andreika-git/prometheus/hardware/prometheus-bare-pcb.jpg

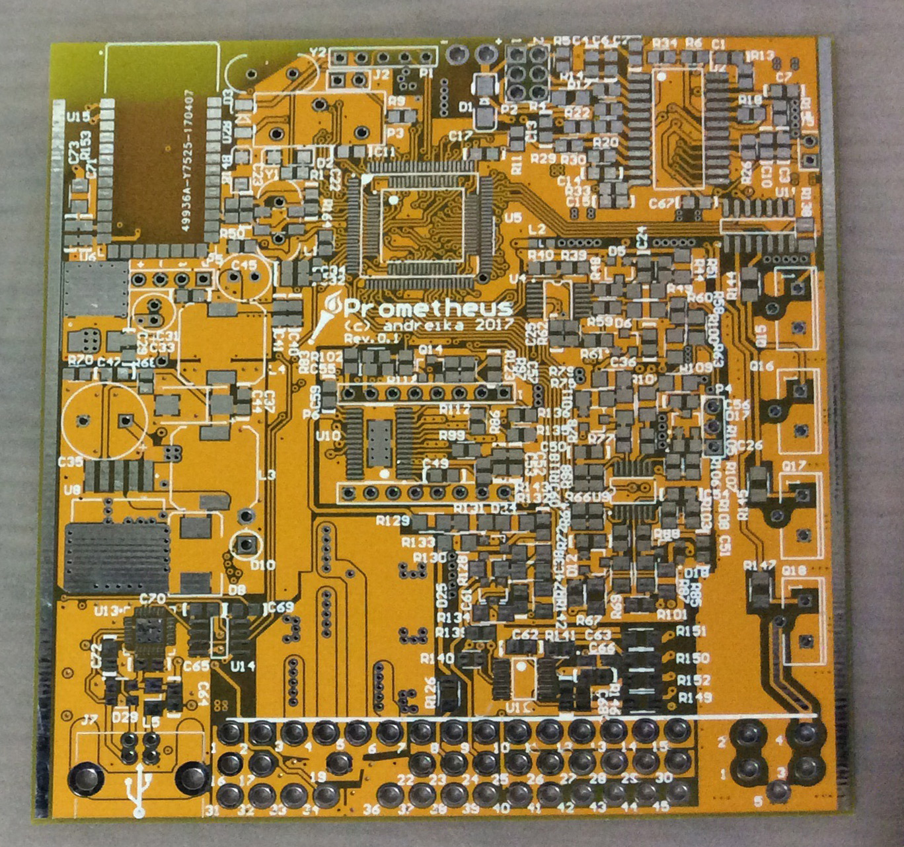
hardware/prometheus-bare-pcb.jpg
