andreika-git/prometheus/hardware/prometheus-pcb-3d-top.jpg

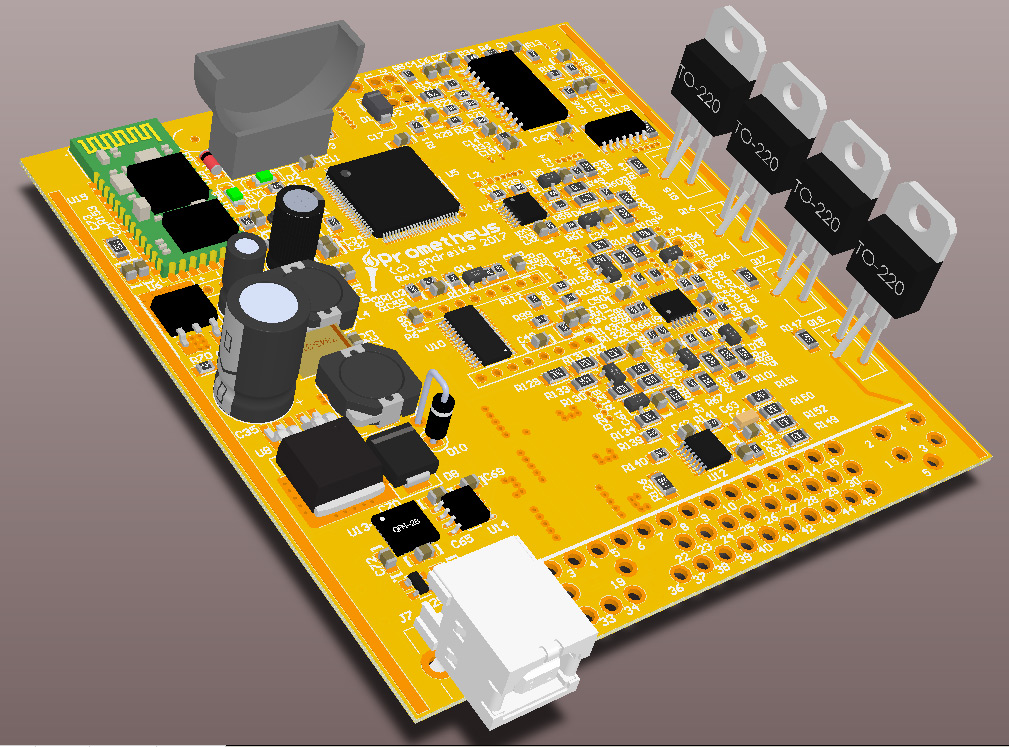
hardware/prometheus-pcb-3d-top.jpg
