andreika-git/prometheus/README.md

*** Hardware Project "Prometheus" ***

See http://rusefi.com/forum/viewtopic.php?f=4&t=1215

Revision 0.020 2018-01-30
Copyright (c) 2017-2018 andreika (prometheus.pcb@gmail.com)

Licensed under the TAPR Open Hardware License (www.tapr.org/OHL)
See LICENSE.TXT for details.

Disclaimer and licence

THIS DOCUMENTATION (SCHEMATIC DIAGRAMS, LAYOUT FILES etc.) IS PROVIDED "AS IS", 
WITHOUT WARRANTY OF ANY KIND, EXPRESS OR IMPLIED, INCLUDING BUT NOT LIMITED TO 
THE WARRANTIES OF MERCHANTABILITY, FITNESS FOR A PARTICULAR PURPOSE AND NONINFRINGEMENT.

IN NO EVENT SHALL THE AUTHORS OR COPYRIGHT HOLDERS BE LIABLE FOR ANY CLAIM, 
DAMAGES OR OTHER LIABILITY, WHETHER IN AN ACTION OF CONTRACT, TORT OR OTHERWISE, 
ARISING FROM, OUT OF OR IN CONNECTION WITH THE DOCUMENTATION OR THE USE OR OTHER 
DEALINGS IN THE DERIVED PRODUCTS.

Author of the Prometheus project is not liable for any damage caused to you or your car
by using this documentation or any associated products.
Whatever you do, you do at your own risk and on your own responsibility!
Please be aware that it may affect your safety and the safety of others.
