andreika-git/prometheus/html/src/readme.txt

Generator scripts for Prometheus Interactive Map.

Created for rusEFI/Prometheus project.

(c) andreika, 2017 (prometheus.pcb@gmail.com)

http://rusefi.com/forum/viewtopic.php?f=4&t=1215
http://github.com/andreika-git/prometheus/
