andreika-git/prometheus/hardware/prometheus-pcb-3d-bottom.jpg

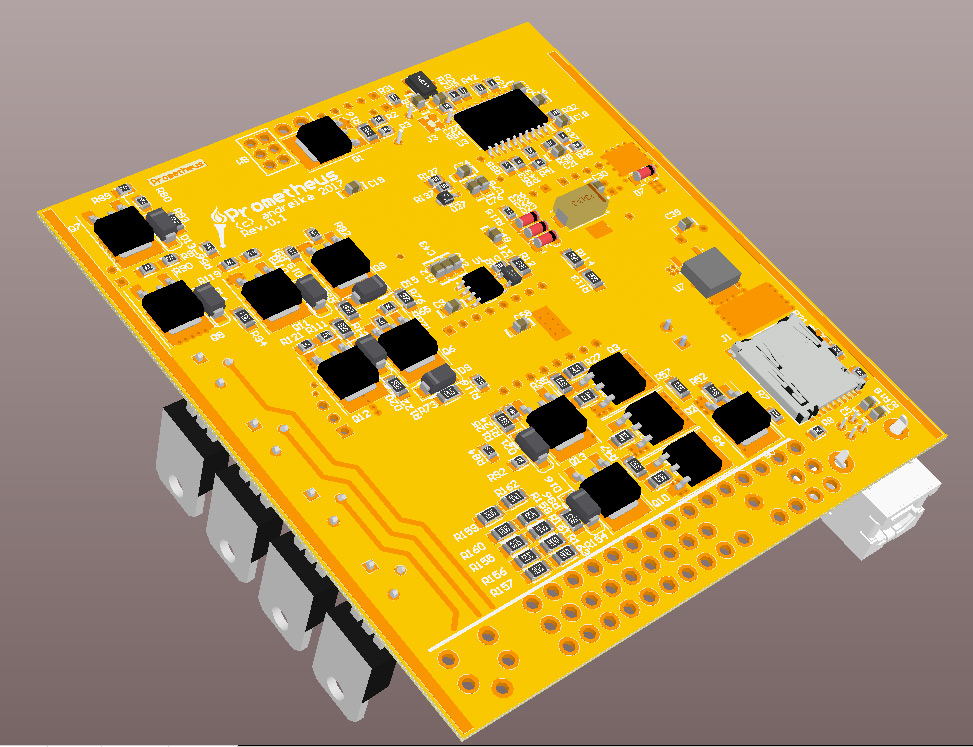
hardware/prometheus-pcb-3d-bottom.jpg
