andreika-git/prometheus/hardware/prometheus-pcb-all-layers.png

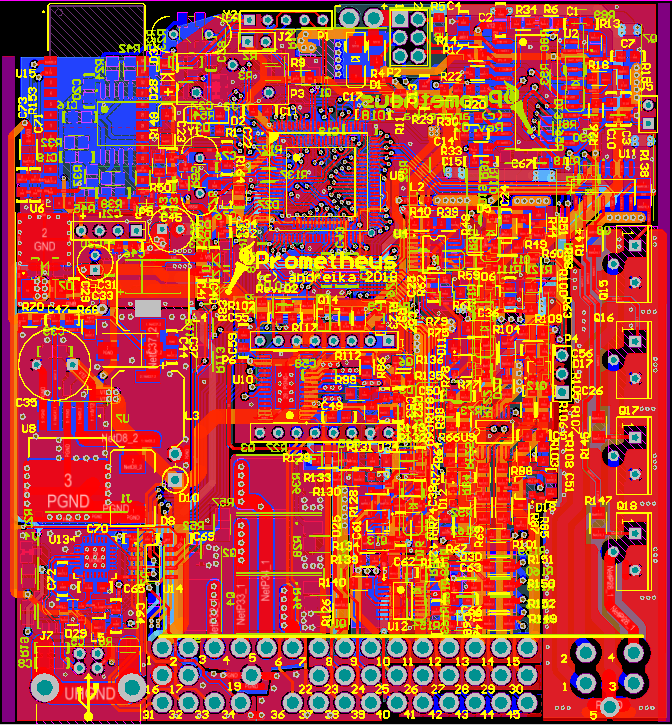
hardware/prometheus-pcb-all-layers.png
