andreika-git/prometheus/hardware/prometheus-pcb-bottom.jpg

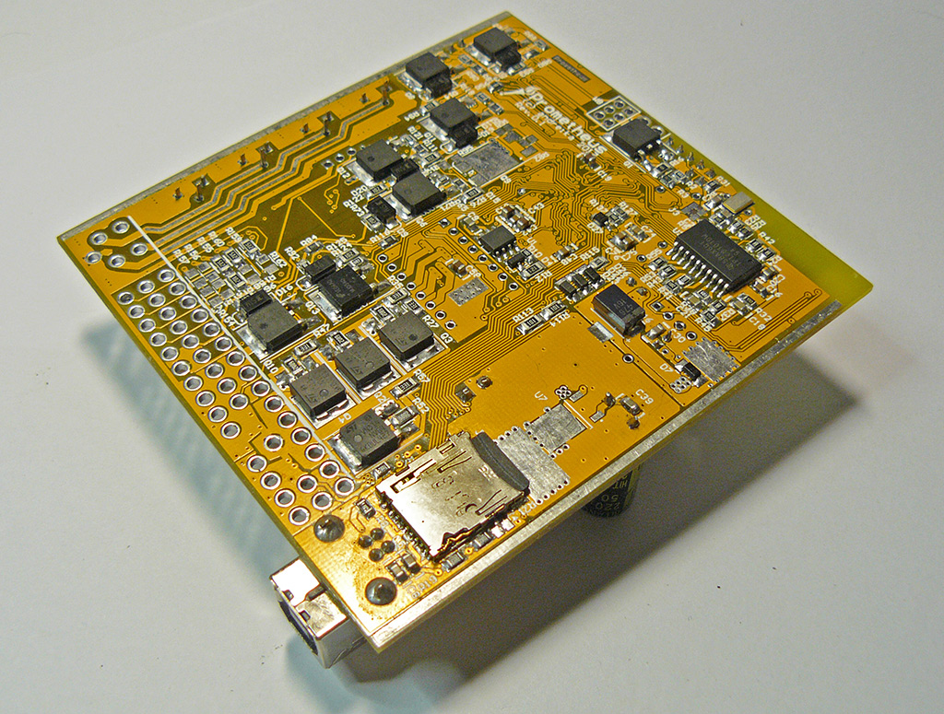
hardware/prometheus-pcb-bottom.jpg
