andreika-git/prometheus/hardware/prometheus-pcb-layers.png

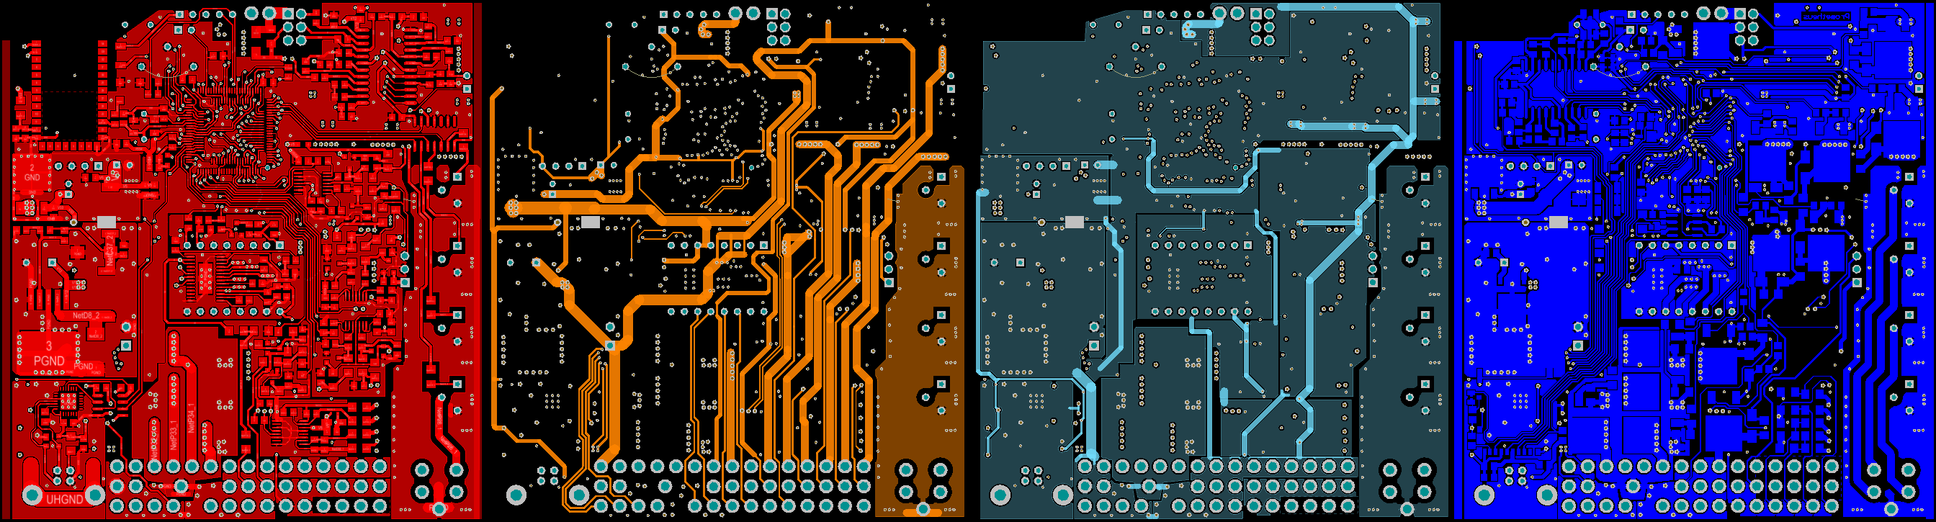
hardware/prometheus-pcb-layers.png
