andreika-git/prometheus/hardware/prometheus-port-mapping.png

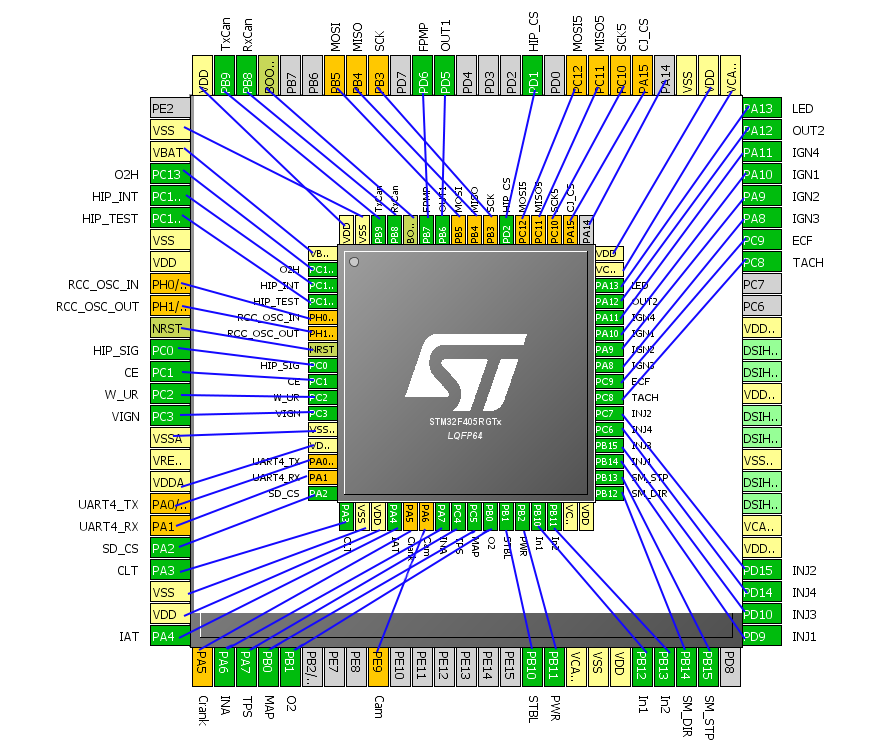
hardware/prometheus-port-mapping.png
