andreika-git/prometheus/html/img/hc-06.jpg

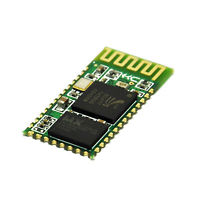
html/img/hc-06.jpg
