andreika-git/prometheus/html/img/image_na.jpg

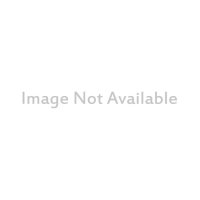
html/img/image_na.jpg
