andreika-git/prometheus/html/prometheus-pcb-rev0010-photo1.jpg

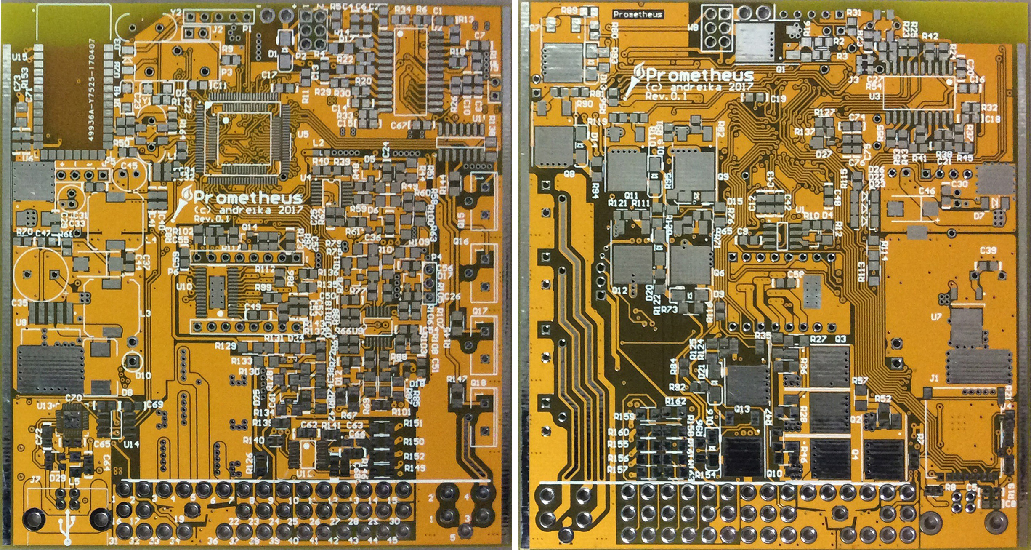
html/prometheus-pcb-rev0010-photo1.jpg
