andreika-git/prometheus/hardware/prometheus-schematic.pdf

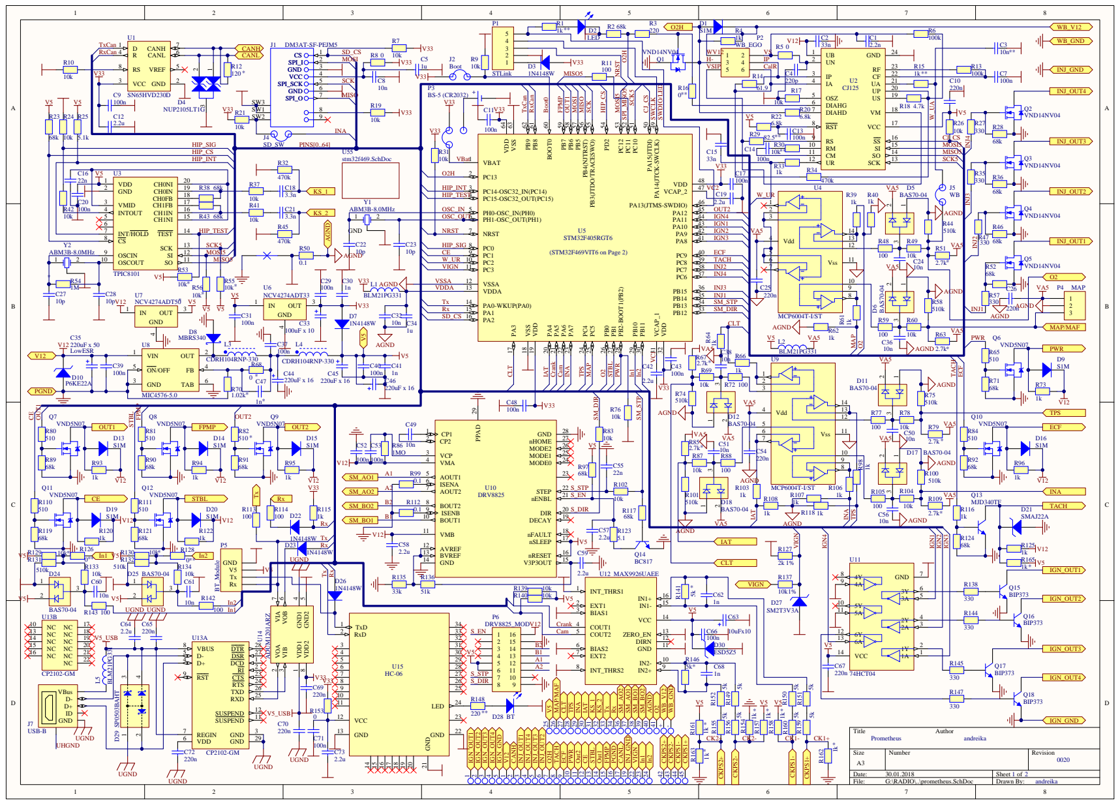
[picture p11: page 1]

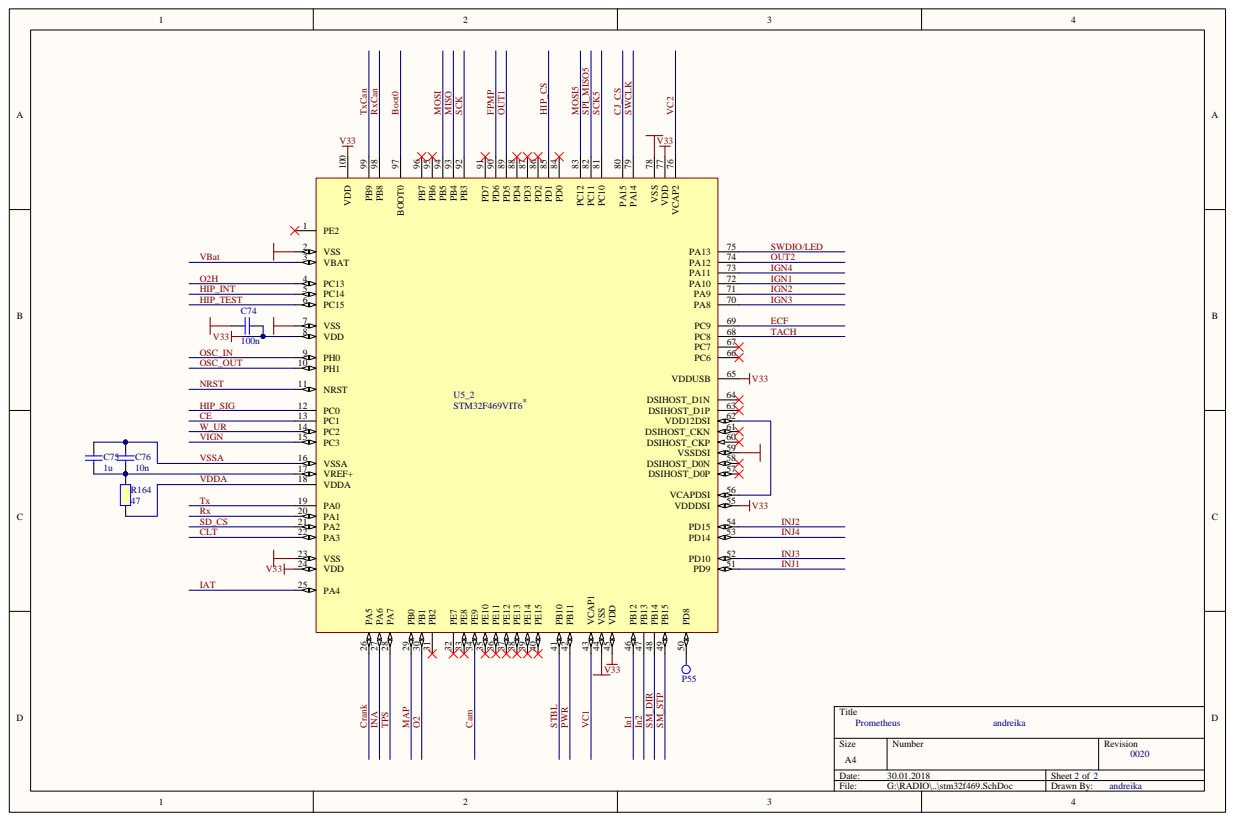
[picture p12: page 2]
Title; Size; Number; Revision; Date:; Sheet of; File:; G:\RADIO\..\stm32f469.SchDoc; Drawn By:; VSSA 16 VREF+ 17; VSS 23; VCAP1 43 VSS 44; VDD 45; VDDDSI; 55 VCAPDSI; DSIHOST_D0P; 57 DSIHOST_D0N; 58 VSSDSI; DSIHOST_CKN; 61 VDD12DSI; VSS 2 VBAT 3; VDD 8; NRST 11; VDD 24; VSS 7; DSIHOST_CKP; DSIHOST_D1N; VDDA 18; DSIHOST_D1P; VDDUSB; VCAP2 76 VDD 77 VSS 78; BOOT0 97; VDD 100; U5_2 STM32F469VIT6; VBat; V33 Boot0; VC² VC¹; VSSA; VDDA; OSC_IN OSC_OUT; NRST; HIP_SIG CE; VIGN; Tx Rx SD_CS CLT; IAT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
