andreika-git/prometheus/hardware/prometheus-wiring-diagram.pdf

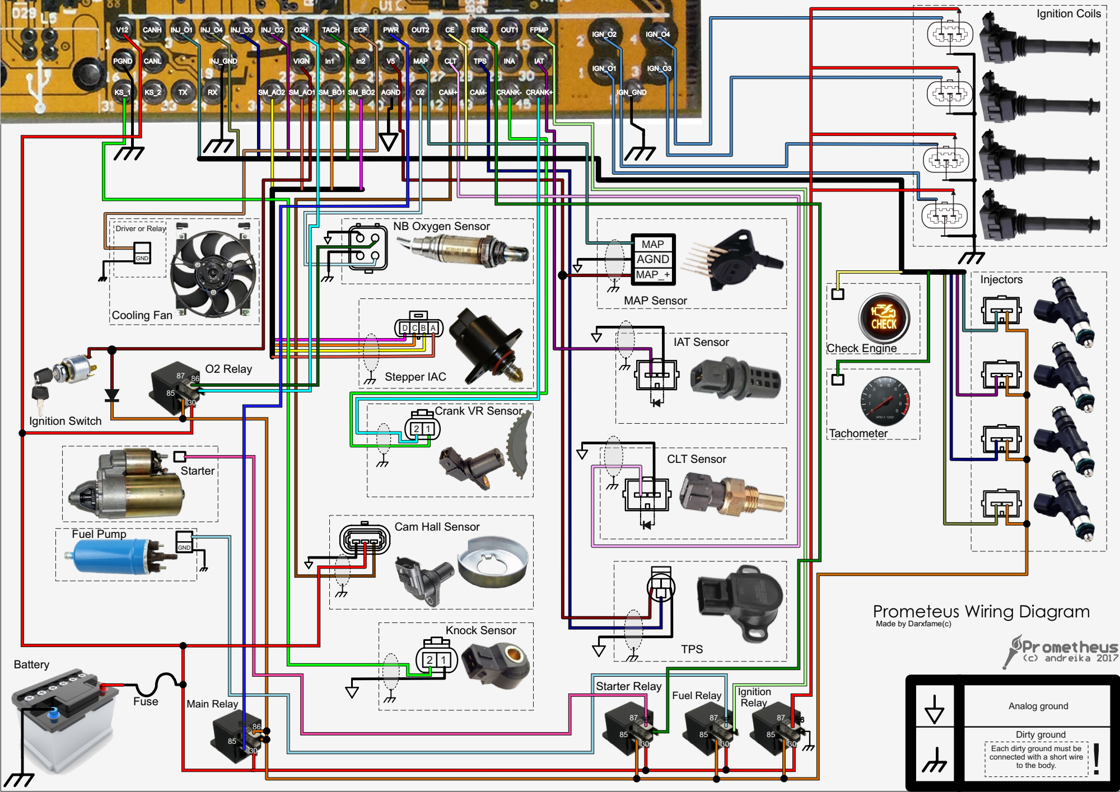
[picture p13: page 1]
Dirty ground; Analog ground; to the body.; MAP_+; AGND; MAP; GND; PGND; CANL; INJ_GND; CANH; INJ_O1; INJ_O4; INJ_O3; INJ_O2; VIGN; TACH; ECF; PWR; OUT2; STBL; CLT; CAM+; CAM-; TPS; OUT1; FPMP; INA; IAT; CRANK- CRANK+; IGN_GND; IGN_O1; IGN_O3; IGN_O2; IGN_O4; Ignition Coils; Injectors; Check Engine; Tachometer; MAP Sensor; IAT Sensor; CLT Sensor; Stepper IAC; Knock Sensor; Cooling Fan; Ignition Switch; Starter; Fuel Pump; Battery; Fuse; O2 Relay; Main Relay; Starter Relay; Fuel Relay; Ignition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

NB Oxygen Sensor

Driver or Relay

Crank VR Sensor

Cam Hall Sensor

Prometeus Wiring Diagram Made by Darxfame(c)

Each dirty ground must be
connected with a short wire
