andreika-git/prometheus/hardware/prometheus-assembly.pdf

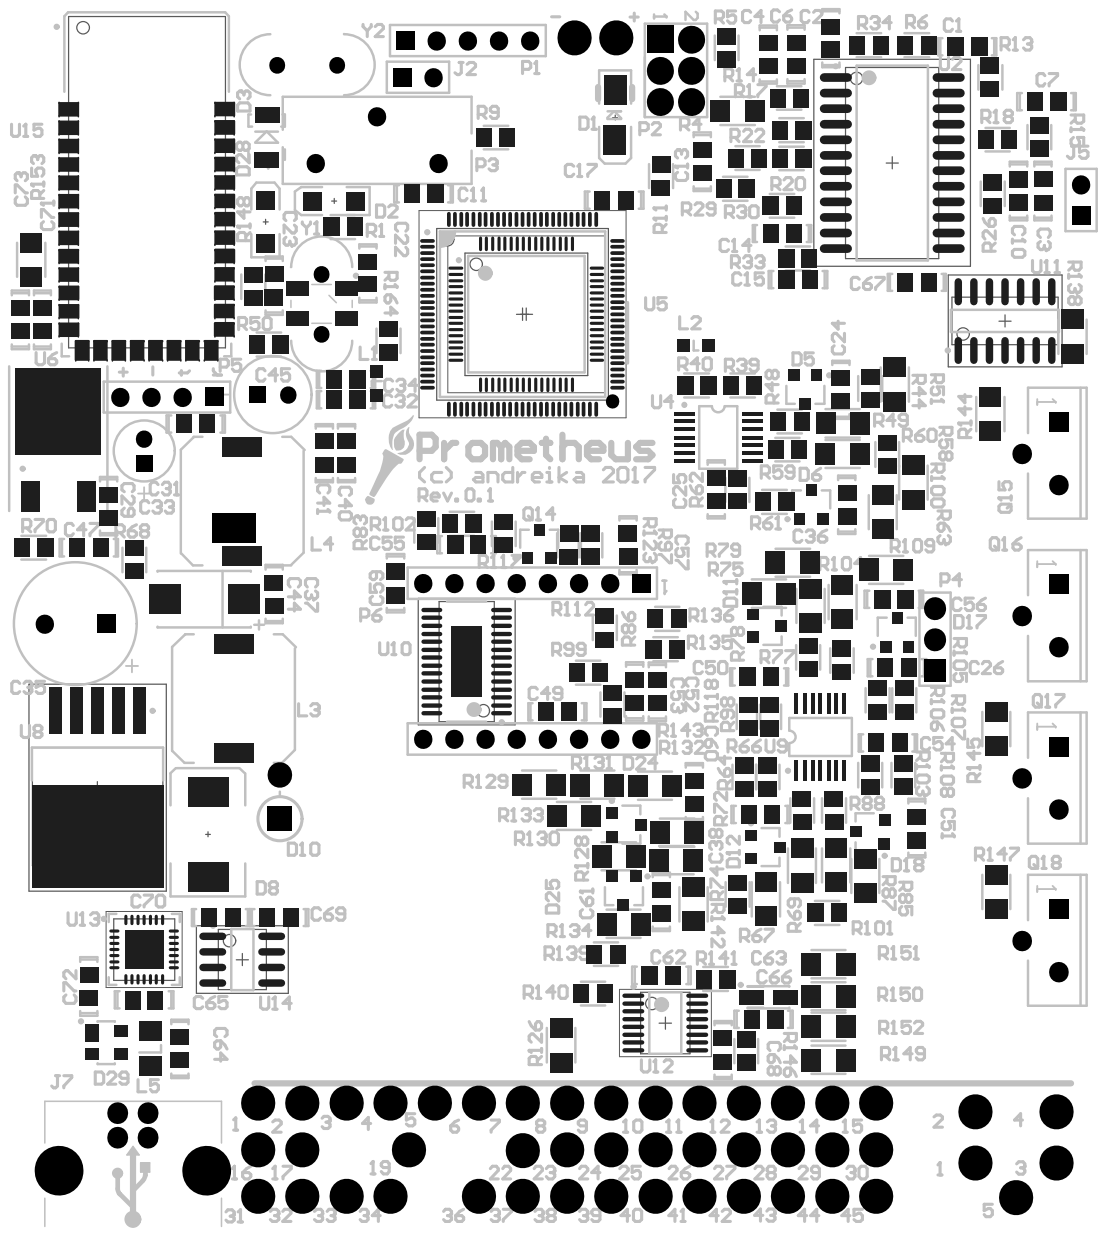
[picture p14: page 1]

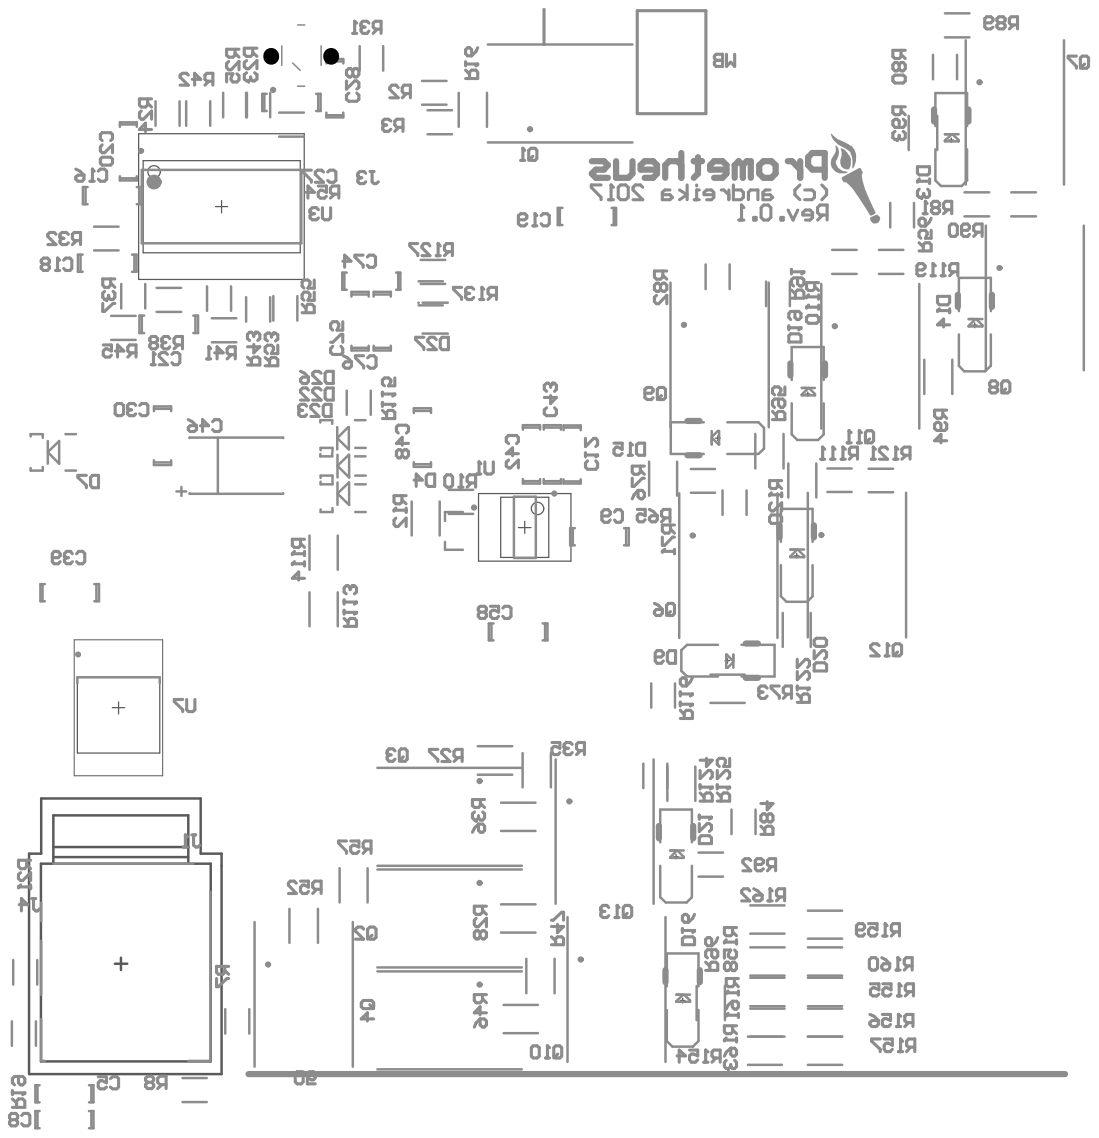
[picture p15: page 2]

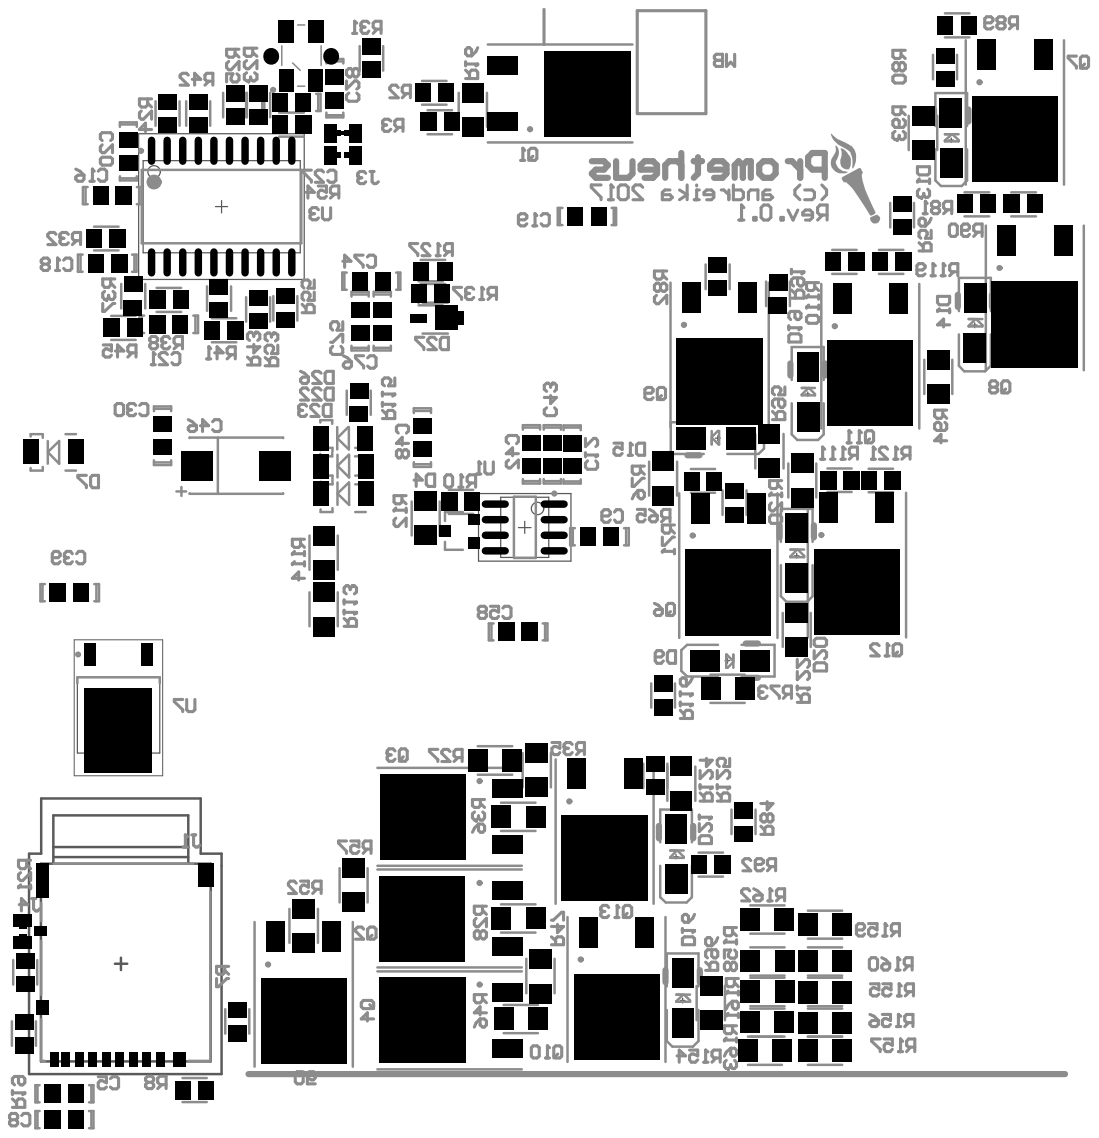
[picture p16: page 4]
