andreika-git/prometheus/hardware/pinout-stm32f469.ioc

Mcu.UserName=STM32F469VITx
PA0/WKUP.Signal=UART4_TX
PA1.Signal=UART4_RX
PA10.GPIO_Label=IGN1
PA10.Signal=GPIO_Output
PA11.GPIO_Label=IGN4
PA11.Signal=GPIO_Output
PA12.GPIO_Label=OUT2
PA12.Signal=GPIO_Output
PA13.GPIO_Label=LED
PA13.Signal=GPIO_Output
PA15.GPIO_Label=CJ_CS
PA15.Signal=SPI3_NSS
PA2.GPIO_Label=SD_CS
PA2.Signal=GPIO_Output
PA3.GPIO_Label=CLT
PA3.Signal=ADCx_IN3
PA4.GPIO_Label=IAT
PA4.Signal=ADCx_IN4
PA5.GPIO_Label=Crank
PA5.Signal=S_TIM2_CH1_ETR
PA6.GPIO_Label=INA
PA6.Signal=ADCx_IN6
PA7.GPIO_Label=TPS
PA7.Signal=ADCx_IN7
PA8.GPIO_Label=IGN3
PA8.Signal=GPIO_Output
PA9.GPIO_Label=IGN2
PA9.Signal=GPIO_Output
PB0.GPIO_Label=MAP
PB0.Signal=ADCx_IN8
PB1.GPIO_Label=O2
PB1.Signal=ADCx_IN9
PB10.GPIO_Label=STBL
PB10.Signal=GPIO_Output
PB11.GPIO_Label=PWR
PB11.Signal=GPIO_Output
PB12.GPIO_Label=In1
PB12.Signal=GPIO_Input
PB13.GPIO_Label=In2
PB13.Signal=GPIO_Input
PB14.GPIO_Label=SM_DIR
PB14.Signal=GPIO_Output
PB15.GPIO_Label=SM_STP
PB15.Signal=GPIO_Output
PB3.GPIO_Label=SCK
PB3.Signal=SPI1_SCK
PB4.GPIO_Label=MISO
PB4.Signal=SPI1_MISO
PB5.GPIO_Label=MOSI
PB5.Signal=SPI1_MOSI
PB8.GPIO_Label=RxCan
PB8.Signal=CAN1_RX
PB9.GPIO_Label=TxCan
PB9.Signal=CAN1_TX
PC0.GPIO_Label=HIP_SIG
PC0.Signal=ADCx_IN10
PC1.GPIO_Label=CE
PC1.Signal=GPIO_Output
PC10.GPIO_Label=SCK5
PC10.Signal=SPI3_SCK
PC11.GPIO_Label=MISO5
PC11.Signal=SPI3_MISO
PC12.GPIO_Label=MOSI5
PC12.Signal=SPI3_MOSI
PC13.GPIO_Label=O2H
PC13.Signal=GPIO_Output
PC14/OSC32_IN.GPIO_Label=HIP_INT
PC14/OSC32_IN.Signal=GPIO_Output
PC15/OSC32_OUT.GPIO_Label=HIP_TEST
PC15/OSC32_OUT.Signal=GPIO_Output
PC2.GPIO_Label=W_UR
PC2.Signal=ADCx_IN12
PC3.GPIO_Label=VIGN
PC3.Signal=ADCx_IN13
PC8.GPIO_Label=TACH
PC8.Signal=GPIO_Output
PC9.GPIO_Label=ECF
PC9.Signal=GPIO_Output
PD1.GPIO_Label=HIP_CS
PD1.Signal=GPIO_Output
PD10.GPIO_Label=INJ3
PD10.Signal=GPIO_Output
PD14.GPIO_Label=INJ4
PD14.Signal=GPIO_Output
PD15.GPIO_Label=INJ2
PD15.Signal=GPIO_Output
PD5.GPIO_Label=OUT1
PD5.Signal=GPIO_Output
PD6.GPIO_Label=FPMP
PD6.Signal=GPIO_Output
PD9.GPIO_Label=INJ1
PD9.Signal=GPIO_Output
PE9.GPIO_Label=Cam
PE9.Signal=S_TIM1_CH1
PH0/OSC_IN.Signal=RCC_OSC_IN
PH1/OSC_OUT.Signal=RCC_OSC_OUT
