andreika-git/prometheus/(commit log)

2017-04-26 prometheus-map small refactor & source script files
    [prometheus-bom.csv, prometheus-bom.xls, prometheus-footprints.csv, prometheus-pick-and-place.csv]
2017-04-26 prometheus-map C35 fix
    [prometheus-bom.csv]
2017-05-08 BOM fix
    [prometheus-bom.csv, prometheus-bom.xls, prometheus-footprints.csv, prometheus-pick-and-place.csv]
2017-05-11 schematic & gerber files rev.0.1 (2017-04-07)!
2017-06-06 assembled board photos rev.0.1 (2017-04-07)
2018-01-30 Progress to rev.0.2 (2018-01-30)
    [prometheus-bom.csv, prometheus-bom.xls]
2018-01-30 Fix a few errors on html-map
    [prometheus-bom.csv]
2019-03-13 upload current 469 firmware
